akheron/punos/hardware/punos-link/README.md

# punos-link

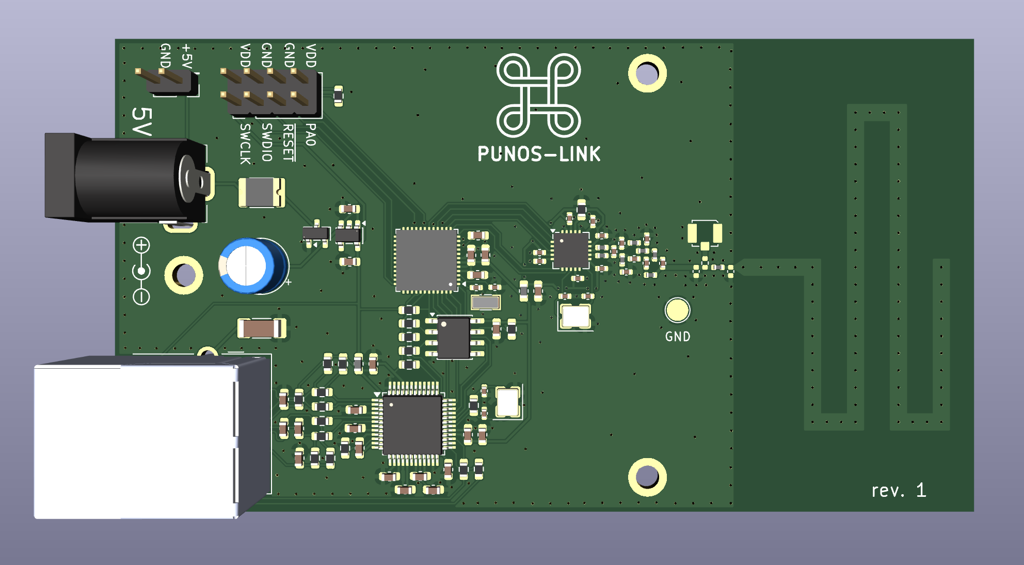
[picture p1: hardware/punos-link/punos-link.png]
punos-link PCB rendering


Punos-link publishes data from punos devices to MQTT over Ethernet.

Features:
- MCU: STM32G071
- Connectivity: TI CC1101 + 868 MHz trace antenna
- Ethernet: WizNet W5500, Hanrun HR911105A
- External flash: 512 KB SPI NOR (for firmware updates over Ethernet)
- Power: 5V / 300 mA

KiCanvas:
- [View schematic](https://kicanvas.org/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)
- [View PCB](https://kicanvas.org/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)

License: [CERN-OHL-P](LICENSE.txt), except [CC BY-SA](LICENSE-3RD-PARTY.md) for files in [lib/3dmodels/](lib/3dmodels/).
