akheron/punos/hardware/punos-link/punos-link.kicad_pcb

## KiCad design hardware/punos-link/punos-link.kicad_pcb (2026-10-31)

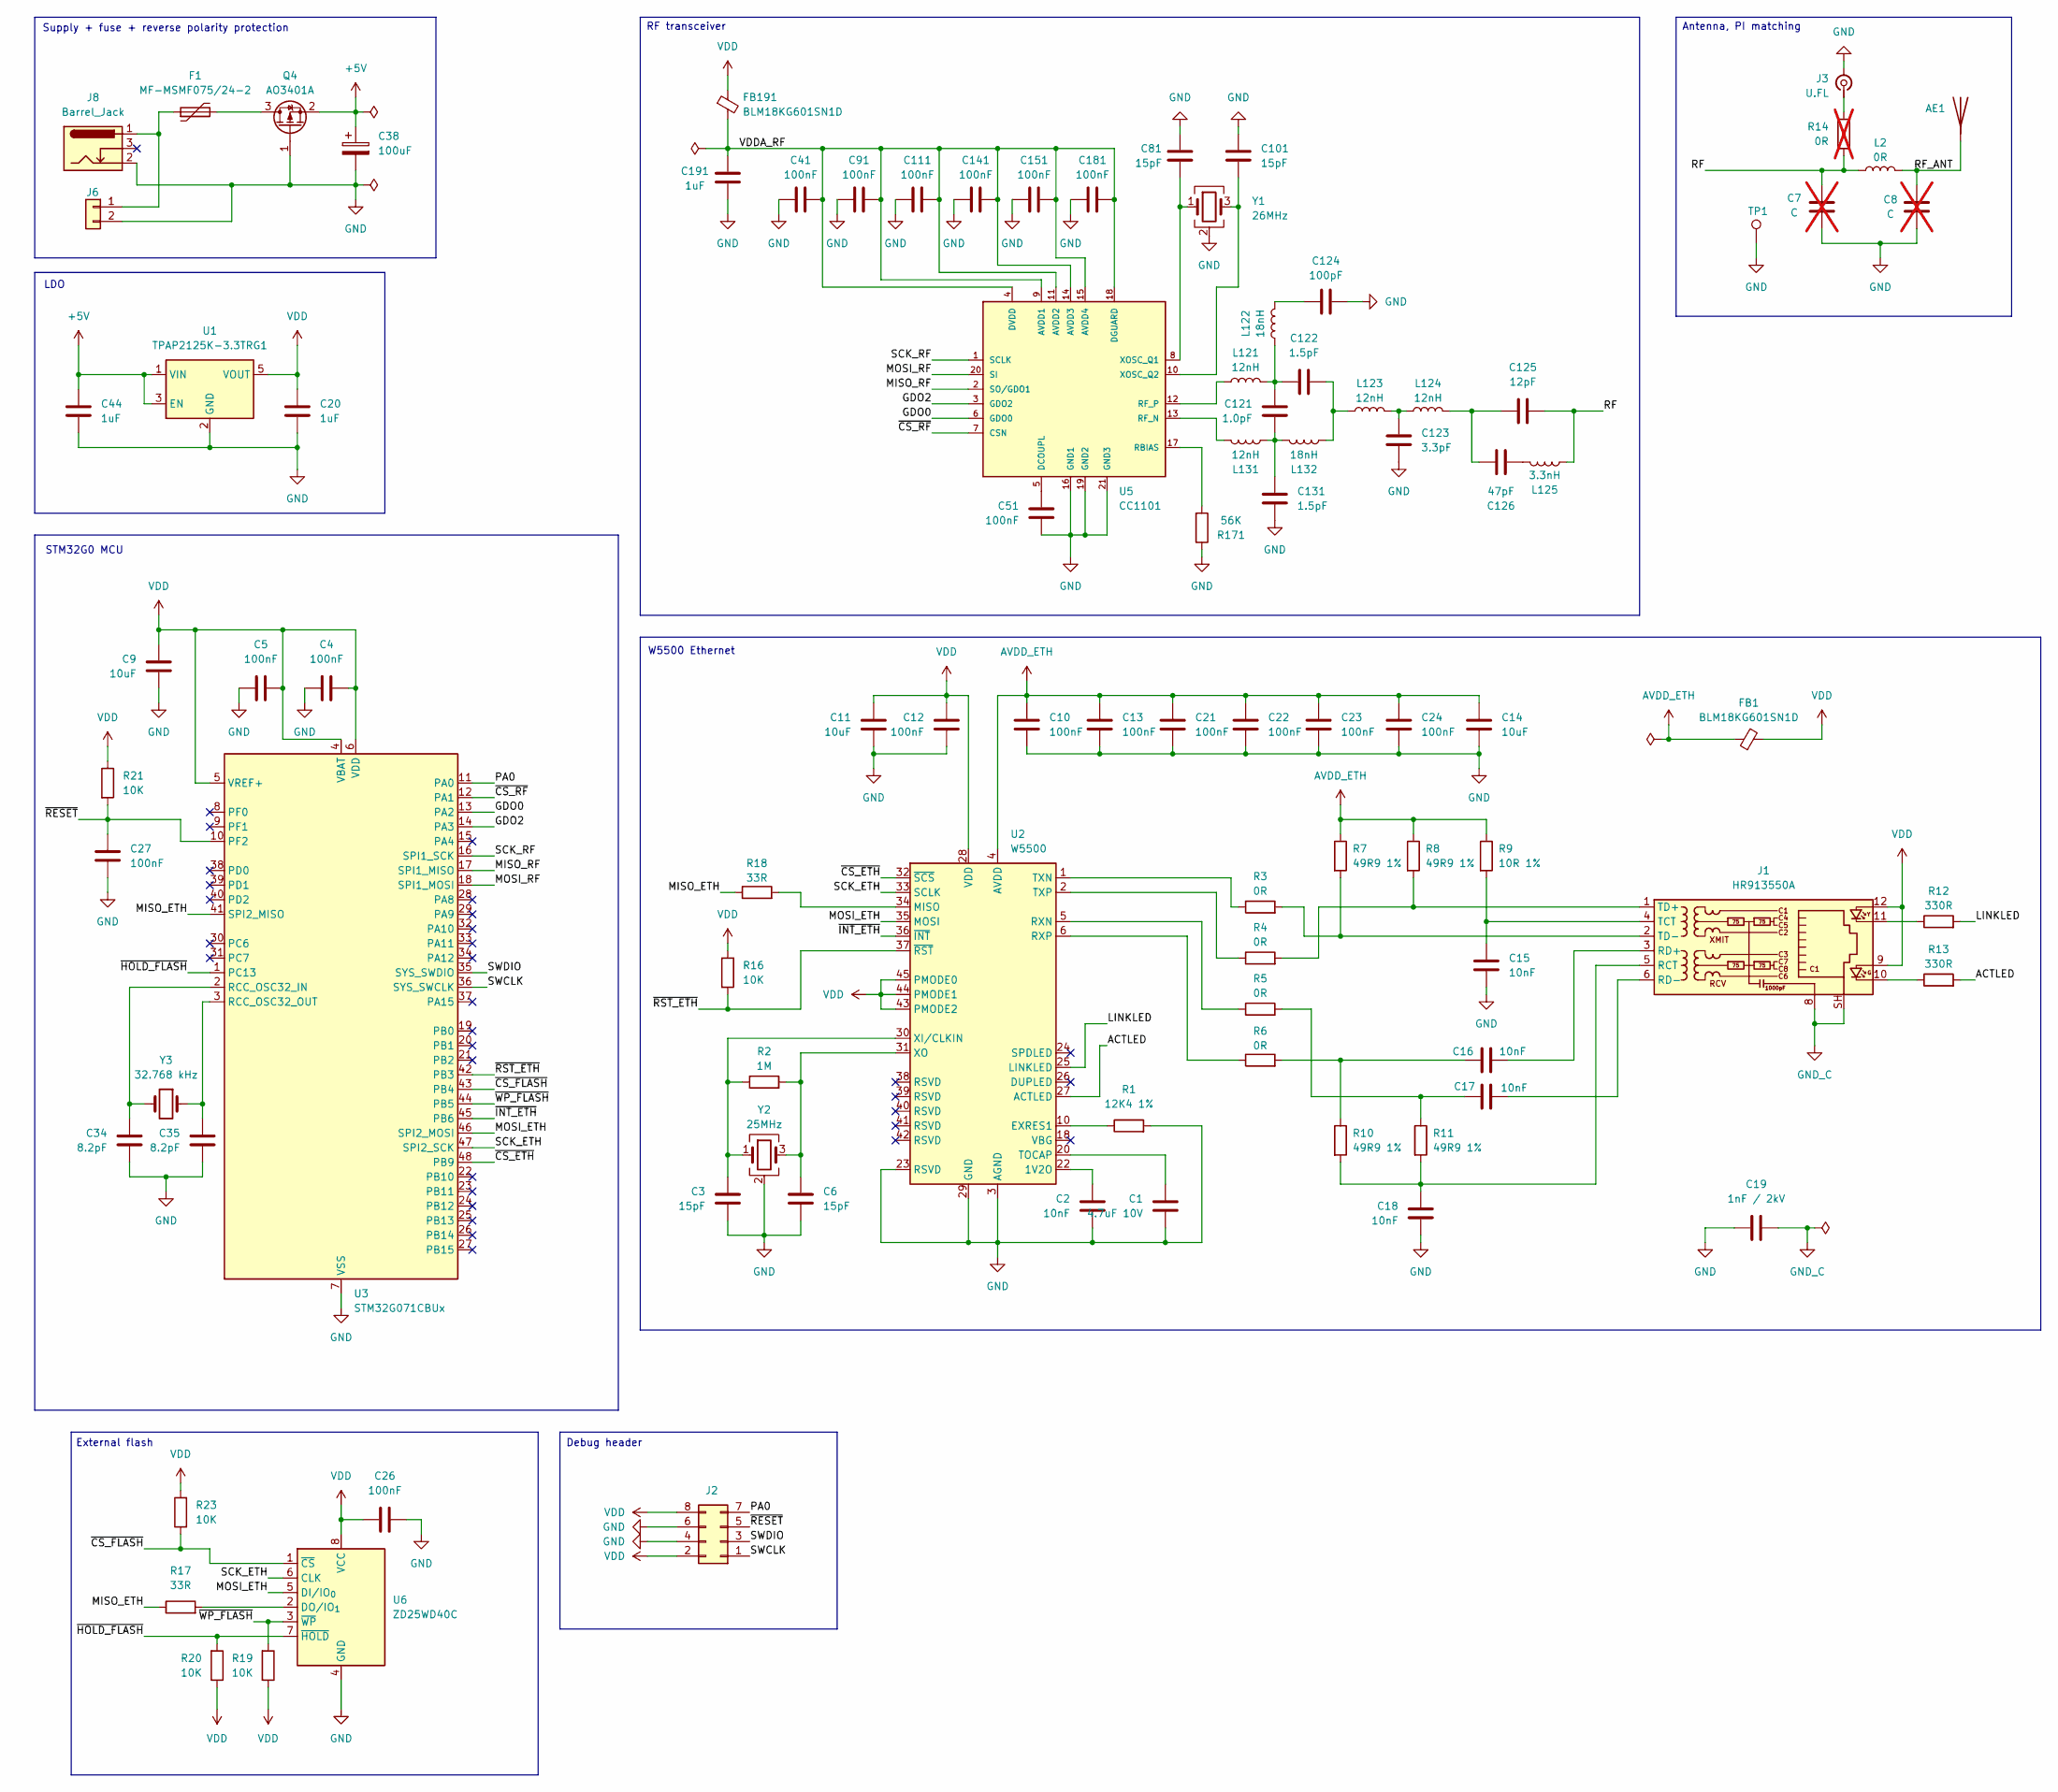
[picture p2: schematic punos-link.kicad_sch]

Parts:
AE1: Pin_D0.9mm_L10.0mm_W2.4mm_FlatFork
C1: 4.7uF 10V; C_0603_1608Metric
C2, C15, C16, C17, C18: 10nF; C_0603_1608Metric
C3, C6, C81, C101: 15pF; C_0402_1005Metric; LCSC C76950
C4, C5, C10, C12, C13, C21, C22, C23, C24, C26: 100nF; C_0603_1608Metric
C7, C8: C; C_0402_1005Metric; not fitted
C9, C11, C14: 10uF; C_0603_1608Metric
C19: 1nF / 2kV; C_1808_4520Metric; LCSC C76916
C20, C44, C191: 1uF; C_0603_1608Metric
C27: 100nF; C_0603_1608Metric; LCSC C77055
C34, C35: 8.2pF; C_0402_1005Metric; LCSC C76984
C38: 100uF; CP_Radial_D6.3mm_P2.50mm; LCSC C46471651
C41, C51, C91, C111, C141, C151, C181: 100nF; C_0402_1005Metric; LCSC C77020
C121: 1.0pF; C_0402_1005Metric; LCSC C76953
C122, C131: 1.5pF; C_0402_1005Metric; LCSC C76958
C123: 3.3pF; C_0402_1005Metric; LCSC C76968
C124: 100pF; C_0402_1005Metric; LCSC C77177
C125: 12pF; C_0402_1005Metric; LCSC C76948
C126: 47pF; C_0402_1005Metric; LCSC C76970
F1: MF-MSMF075/24-2; Fuse_1812_4532Metric; LCSC C208467
FB1, FB191: BLM18KG601SN1D; L_0603_1608Metric; LCSC C85833
J1: HR913550A; RJ45_Hanrun_HR911105A_Horizontal; LCSC C163507
J2: Conn_02x04; PinHeader_2x04_P2.54mm_Vertical
J3: U.FL; BAT-WIRELESS-BWU.FL-IPEX1; LCSC C5137195
J6: Conn_01x02; PinHeader_2x01_P2.54mm_Vertical
J8: Barrel_Jack; TLZWLA-DC-005
L2: 0R; L_0402_1005Metric; LCSC C106231
L121, L123, L124, L131: 12nH; L_0402_1005Metric; LCSC C86128
L122, L132: 18nH; L_0402_1005Metric; LCSC C91622
L125: 3.3nH; L_0402_1005Metric; LCSC C3223325
Q4: AO3401A; SOT-23; LCSC C15127
R1: 12K4 1%; R_0603_1608Metric
R2: 1M; R_0603_1608Metric
R3, R4, R5, R6: 0R; R_0603_1608Metric
R7, R8, R10, R11: 49R9 1%; R_0603_1608Metric
R9: 10R 1%; R_0603_1608Metric
R12, R13: 330R; R_0603_1608Metric
R14: 0R; R_0402_1005Metric; not fitted
R16, R19, R20, R21, R23: 10K; R_0603_1608Metric
R17, R18: 33R; R_0603_1608Metric
R171: 56K; R_0603_1608Metric; LCSC C114630
TP1: TestPoint; TestPoint_Pad_D2.5mm
U1: TPAP2125K-3.3TRG1; SOT-23-5; LCSC C49451997
U2: W5500; LQFP-48_7x7mm_P0.5mm; LCSC C32843
U3: STM32G071CBUx; QFN-48-1EP_7x7mm_P0.5mm_EP5.6x5.6mm; LCSC C529343
U5: CC1101; Texas_RGP0020H_VQFN-20-1EP_4x4mm_P0.5mm_EP2.4x2.4mm; LCSC C2654650
U6: ZD25WD40C; SOIC-8_3.9x4.9mm_P1.27mm; LCSC C55863470
Y1: 26MHz; Crystal_SMD_3225-4Pin_3.2x2.5mm; LCSC C5444608
Y2: 25MHz; Crystal_SMD_3225-4Pin_3.2x2.5mm; LCSC C70582
Y3: 32.768 kHz; Crystal_SMD_3215-2Pin_3.2x1.5mm; LCSC C94674

Connections:
+5V: C38.1, C44.1, Q4.2 (S), U1.1 (VIN), U1.3 (EN)
/ACTLED: R13.2, U2.27 (ACTLED)
/GDO0: U3.13 (PA2), U5.6 (GDO0)
/GDO2: U3.14 (PA3), U5.3 (GDO2)
/LINKLED: R12.2, U2.25 (LINKLED)
/MISO_ETH: R17.1, R18.1, U3.41 (SPI2_MISO)
/MISO_RF: U3.17 (SPI1_MISO), U5.2 (SO/GDO1)
/MOSI_ETH: U2.35 (MOSI), U3.46 (SPI2_MOSI), U6.5 (DI/IO_{0})
/MOSI_RF: U3.18 (SPI1_MOSI), U5.20 (SI)
/PA0: J2.7, U3.11 (PA0)
/RF: C7.1, C125.2, L2.2, L125.1, R14.2
/RF_ANT: AE1.1, C8.1, L2.1
/SCK_ETH: U2.33 (SCLK), U3.47 (SPI2_SCK), U6.6 (CLK)
/SCK_RF: U3.16 (SPI1_SCK), U5.1 (SCLK)
/SWCLK: J2.1, U3.36 (SYS_SWCLK)
/SWDIO: J2.3, U3.35 (SYS_SWDIO)
/VDDA_RF: C41.2, C91.2, C111.2, C141.2, C151.2, C181.2, C191.2, FB191.2, U5.4 (DVDD), U5.9 (AVDD1), U5.11 (AVDD2), U5.14 (AVDD3), U5.15 (AVDD4), U5.18 (DGUARD)
/~CS_ETH: U2.32 (~SCS), U3.48 (PB9)
/~CS_FLASH: R23.1, U3.43 (PB4), U6.1 (~CS)
/~CS_RF: U3.12 (PA1), U5.7 (CSN)
/~HOLD_FLASH: R20.2, U3.1 (PC13), U6.7 (~HOLD)
/~INT_ETH: U2.36 (~INT), U3.45 (PB6)
/~RESET: C27.1, J2.5, R21.2, U3.10 (PF2)
/~RST_ETH: R16.2, U2.37 (~RST), U3.42 (PB3)
/~WP_FLASH: R19.2, U3.44 (PB5), U6.3 (~WP)
AVDD_ETH: C10.1, C13.1, C14.1, C21.1, C22.1, C23.1, C24.1, FB1.1, R7.1, R8.1, R9.1, U2.4 (AVDD), U2.8 (AVDD), U2.11 (AVDD), U2.15 (AVDD), U2.17 (AVDD), U2.21 (AVDD)
GND: C1.2, C2.2, C3.2, C4.1, C5.1, C6.2, C7.2, C8.2, C9.1, C10.2, C11.1, C12.2, C13.2, C14.2, C15.2, C18.2, C19.1, C20.2, C21.2, C22.2, C23.2, C24.2, C26.2, C27.2, C34.2, C35.2, C38.2, C41.1, C44.2, C51.2, C81.1, C91.1, C101.1, C111.1, C123.2, C124.1, C131.1, C141.1, C151.1, C181.1, C191.1, J2.4, J2.6, J3.2 (Ext), J6.2, J8.2, Q4.1 (G), R1.2, R171.1, TP1.1 (1_1), U1.2 (GND), U2.3 (AGND), U2.9 (AGND), U2.14 (AGND), U2.16 (AGND), U2.19 (AGND), U2.23 (RSVD), U2.29 (GND), U2.48 (AGND), U3.7 (VSS), U3.49 (VSS), U5.16 (GND1), U5.19 (GND2), U5.21 (GND3), U6.4 (GND), Y1.2 (G), Y1.4 (G), Y2.2 (G), Y2.4 (G)
GND_C: C19.2, J1.8, J1.SH
unnamed: C16.2, R6.2, R10.1
unnamed: C17.2, R5.2, R11.1
unnamed: C121.1, C131.2, L131.2, L132.1
unnamed: C121.2, C122.1, L121.1, L122.1
unnamed: C122.2, L123.2, L132.2
unnamed: C123.1, L123.1, L124.2
unnamed: C124.2, L122.2
unnamed: C125.1, C126.1, L124.1
unnamed: C126.2, L125.2
unnamed: J1.10, R13.1
unnamed: J1.11, R12.1
unnamed: C18.1, J1.5 (RCT), R10.2, R11.2
unnamed: C16.1, J1.3 (RD+)
unnamed: C17.1, J1.6 (RD-)
unnamed: C15.1, J1.4 (TCT), R9.2
unnamed: J1.1 (TD+), R4.2, R8.2
unnamed: J1.2 (TD-), R3.2, R7.2
unnamed: J3.1 (In), R14.1
unnamed: F1.1, J6.1, J8.1
unnamed: F1.2, Q4.3 (D)
unnamed: C2.1, U2.22 (1V2O)
unnamed: R1.1, U2.10 (EXRES1)
unnamed: R18.2, U2.34 (MISO)
unnamed: R5.1, U2.5 (RXN)
unnamed: R6.1, U2.6 (RXP)
unnamed: C1.1, U2.20 (TOCAP)
unnamed: R3.1, U2.1 (TXN)
unnamed: R4.1, U2.2 (TXP)
unnamed: C3.1, R2.1, U2.30 (XI/CLKIN), Y2.1
unnamed: C6.1, R2.2, U2.31 (XO), Y2.3
unnamed: C34.1, U3.2 (RCC_OSC32_IN), Y3.2
unnamed: C35.1, U3.3 (RCC_OSC32_OUT), Y3.1
unnamed: C51.1, U5.5 (DCOUPL)
unnamed: R171.2, U5.17 (RBIAS)
unnamed: L131.1, U5.13 (RF_N)
unnamed: L121.2, U5.12 (RF_P)
unnamed: C81.2, U5.8 (XOSC_Q1), Y1.1
unnamed: C101.2, U5.10 (XOSC_Q2), Y1.3
unnamed: R17.2, U6.2 (DO/IO_{1})
VDD: C4.2, C5.2, C9.2, C11.2, C12.1, C20.1, C26.1, FB1.2, FB191.1, J1.9, J1.12, J2.2, J2.8, R16.1, R19.1, R20.1, R21.1, R23.2, U1.5 (VOUT), U2.28 (VDD), U2.43 (PMODE2), U2.44 (PMODE1), U2.45 (PMODE0), U3.4 (VBAT), U3.5 (VREF+), U3.6 (VDD), U6.8 (VCC)

Notes on the sheet:
LDO
External flash
Supply + fuse + reverse polarity protection
RF transceiver
W5500 Ethernet
STM32G0 MCU
Antenna, PI matching
Debug header

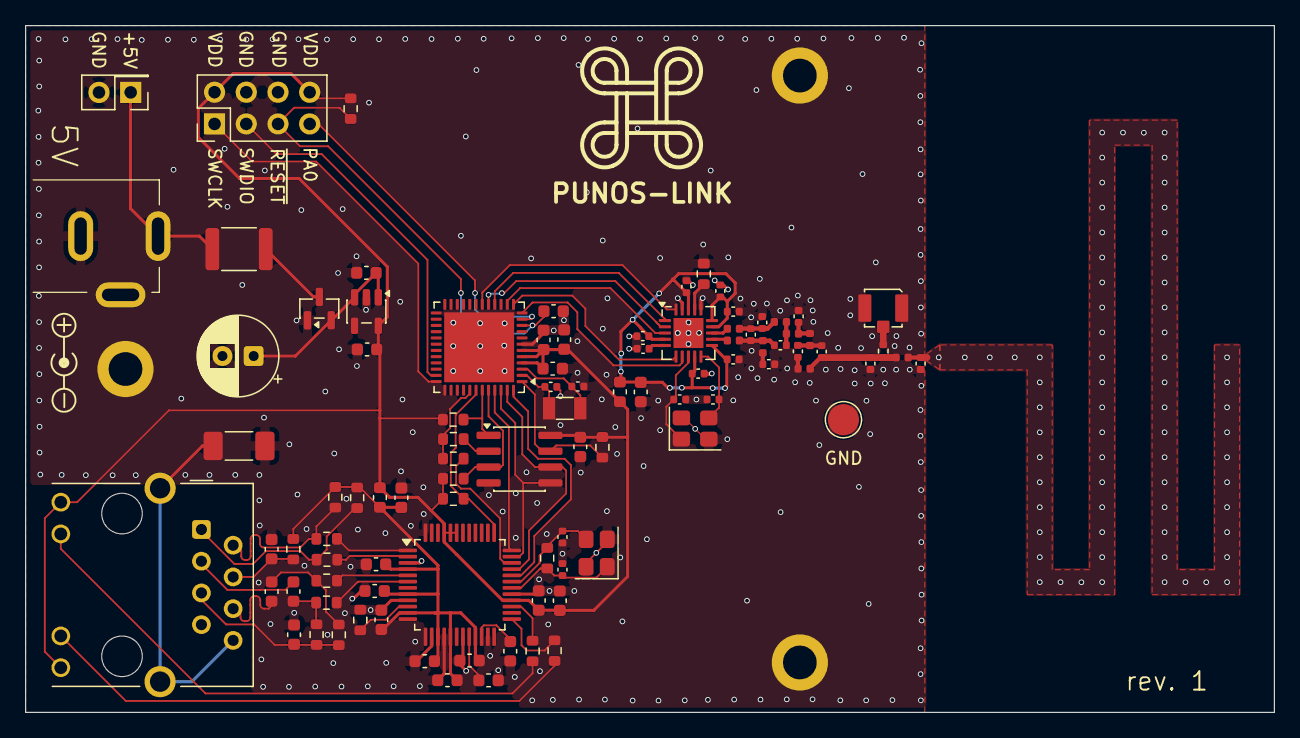
[picture p3: board punos-link.kicad_pcb from above]

Board: 2 copper layers, 100.0 x 55.0 mm, 95 parts (0 on the bottom side), 68 nets.
