akheron/punos/hardware/punos-link/CHANGELOG.md

## 2026-09

* Move footprints and symbols in-tree
* Use newer version of STM32G071CBUx symbol
* Fixes to footprints
* Front layer copper pour
* Add NRST lowpass
* Use THT bulk cap, to VDD instead of +5V
* Move Y cap
* Adjst CC1101 routing, connect crystal shield to ground
* Fix RF SPI pins
* Add LSE crystal
* JLCPCB capabilities, smaller vias

## 2026-08

Initial release
