akheron/punos/(commit log)

2026-09-29 Update punos-link
    [punos-link.kicad_pcb, punos-link.kicad_sch]
2026-10-31 Update punos-link
    * Fab layer
    * Update flash fields
    * Add U.FL/IPEX
    * Update PCB from schematic, change vias to 0.3/0.45 mm
    * Finalize bom
    * Move antenna Pi network a bit
    * Add mounting holes
    * Change ETH TX center tap bypass to 10 nF
    * Update LSE crystal cap properties
    * Use muRata BLM18KG601SN1D for both ferrites
    * Use 10 pF crystal and 15 pF load caps for W5500 too
    * Tune lengths of ETH TX and RX pairs
    * Change ETH RX DC blocking caps to 10 nF 0603
    * Connect VREF+, move NRST decoupling closer to MCU
    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
    [punos-link.kicad_pcb, punos-link.kicad_sch]
